mekatronik-achmadi/tugas_akhir/word_me/Cover.docx

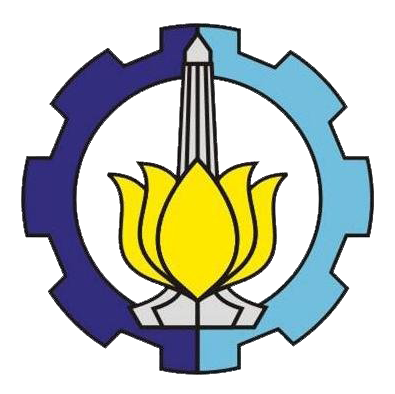
[picture p19: figure]

TUGAS AKHIR – TF 091381

Rancang Bangun Robot Vision Untuk Object

Finding Menggunakan Color Tracking pada

perangkat RaspberryPi

Achmadi

NRP. 2410 100 085

Dosen Pembimbing :

Ir Apriani Kusumawardhani

JURUSAN TEKNIK FISIKA

Fakultas Teknologi Industri

Institut Teknologi Sepuluh Nopember

Surabaya

2014
