mekatronik-achmadi/tugas_akhir/word_me/LAMPIRAN C.docx

LAMPIRAN C: KODE SUMBER C UNTUK FIRMWARE MOTOR CONTROLLER

Seluruh file ini dapat di akses di URL:

https://github.com/mekatronik-achmadi/tugas_akhir/tree/master/software/rtos

Seluruh kode sumber ini dibangun dengan operating system ubuntu atau debian. Kode sumber ini dibangun berdasarkan pustaka ChibiOS/RT yang merupakan pustaka untuk membangun firmware pada mikrokontroller berbasis ARM-Cortex M-series. Kode sumber yang terlampir disini hanyalah kode sumber yang dibuat dalam perancangan ini dan bukan termasuk kode bawaan dari pustaka ChibiOS/RT. File-file tersebut adalah:

1. halconf.h
2. mcuconf.h
3. robot_gpt.h
4. robot_led.h
5. robot_pal.h
6. robot_shell.h
7. srcconf.h
8. main.c
9. robot_gpt.c
10. robot_led.h
11. robot_pal.c
12. robot_shell.c
13. Makefile

Untuk dapat mengkompilasi kode sumber ini maka dibutuhkan paket berikut:

1. gcc-arm-none-eabi
2. libnewlib-arm-none-eabi
3. libnewlib-dev
4. build-essential

Untuk file kode sumber selain yang terlampir disini maka file tersebut merupakan bagian dari pustaka ChibiOS/RT yang digunakan tanpa ada perubahan.Untuk mengkompilasinya tinggal memanggil program make.

      1. File halconf.h

/**

* @file templates/halconf.h

* @brief HAL configuration header.

* @details HAL configuration file, this file allows to enable or disable the

* various device drivers from your application. You may also use

* this file in order to override the device drivers default settings.

*

* @addtogroup HAL_CONF

* @{

*/

#ifndef _HALCONF_H_

#define _HALCONF_H_

#include "mcuconf.h"

/**

* @brief Enables the TM subsystem.

*/

#if !defined(HAL_USE_TM) || defined(__DOXYGEN__)

#define HAL_USE_TM TRUE

#endif

/**

* @brief Enables the PAL subsystem.

*/

#if !defined(HAL_USE_PAL) || defined(__DOXYGEN__)

#define HAL_USE_PAL TRUE

#endif

/**

* @brief Enables the ADC subsystem.

*/

#if !defined(HAL_USE_ADC) || defined(__DOXYGEN__)

#define HAL_USE_ADC FALSE

#endif

/**

* @brief Enables the CAN subsystem.

*/

#if !defined(HAL_USE_CAN) || defined(__DOXYGEN__)

#define HAL_USE_CAN FALSE

#endif

/**

* @brief Enables the EXT subsystem.

*/

#if !defined(HAL_USE_EXT) || defined(__DOXYGEN__)

#define HAL_USE_EXT FALSE

#endif

/**

* @brief Enables the GPT subsystem.

*/

#if !defined(HAL_USE_GPT) || defined(__DOXYGEN__)

#define HAL_USE_GPT TRUE

#endif

/**

* @brief Enables the I2C subsystem.

*/

#if !defined(HAL_USE_I2C) || defined(__DOXYGEN__)

#define HAL_USE_I2C FALSE

#endif

/**

* @brief Enables the ICU subsystem.

*/

#if !defined(HAL_USE_ICU) || defined(__DOXYGEN__)

#define HAL_USE_ICU FALSE

#endif

/**

* @brief Enables the MAC subsystem.

*/

#if !defined(HAL_USE_MAC) || defined(__DOXYGEN__)

#define HAL_USE_MAC FALSE

#endif

/**

* @brief Enables the MMC_SPI subsystem.

*/

#if !defined(HAL_USE_MMC_SPI) || defined(__DOXYGEN__)

#define HAL_USE_MMC_SPI FALSE

#endif

/**

* @brief Enables the PWM subsystem.

*/

#if !defined(HAL_USE_PWM) || defined(__DOXYGEN__)

#define HAL_USE_PWM FALSE

#endif

/**

* @brief Enables the RTC subsystem.

*/

#if !defined(HAL_USE_RTC) || defined(__DOXYGEN__)

#define HAL_USE_RTC FALSE

#endif

/**

* @brief Enables the SDC subsystem.

*/

#if !defined(HAL_USE_SDC) || defined(__DOXYGEN__)

#define HAL_USE_SDC FALSE

#endif

/**

* @brief Enables the SERIAL subsystem.

*/

#if !defined(HAL_USE_SERIAL) || defined(__DOXYGEN__)

#define HAL_USE_SERIAL TRUE

#endif

/**

* @brief Enables the SERIAL over USB subsystem.

*/

#if !defined(HAL_USE_SERIAL_USB) || defined(__DOXYGEN__)

#define HAL_USE_SERIAL_USB FALSE

#endif

/**

* @brief Enables the SPI subsystem.

*/

#if !defined(HAL_USE_SPI) || defined(__DOXYGEN__)

#define HAL_USE_SPI FALSE

#endif

/**

* @brief Enables the UART subsystem.

*/

#if !defined(HAL_USE_UART) || defined(__DOXYGEN__)

#define HAL_USE_UART FALSE

#endif

/**

* @brief Enables the USB subsystem.

*/

#if !defined(HAL_USE_USB) || defined(__DOXYGEN__)

#define HAL_USE_USB FALSE

#endif

/*===========================================================================*/

/* ADC driver related settings. */

/*===========================================================================*/

/**

* @brief Enables synchronous APIs.

* @note Disabling this option saves both code and data space.

*/

#if !defined(ADC_USE_WAIT) || defined(__DOXYGEN__)

#define ADC_USE_WAIT TRUE

#endif

/**

* @brief Enables the @p adcAcquireBus() and @p adcReleaseBus() APIs.

* @note Disabling this option saves both code and data space.

*/

#if !defined(ADC_USE_MUTUAL_EXCLUSION) || defined(__DOXYGEN__)

#define ADC_USE_MUTUAL_EXCLUSION TRUE

#endif

/*===========================================================================*/

/* CAN driver related settings. */

/*===========================================================================*/

/**

* @brief Sleep mode related APIs inclusion switch.

*/

#if !defined(CAN_USE_SLEEP_MODE) || defined(__DOXYGEN__)

#define CAN_USE_SLEEP_MODE TRUE

#endif

/*===========================================================================*/

/* I2C driver related settings. */

/*===========================================================================*/

/**

* @brief Enables the mutual exclusion APIs on the I2C bus.

*/

#if !defined(I2C_USE_MUTUAL_EXCLUSION) || defined(__DOXYGEN__)

#define I2C_USE_MUTUAL_EXCLUSION TRUE

#endif

/*===========================================================================*/

/* MAC driver related settings. */

/*===========================================================================*/

/**

* @brief Enables an event sources for incoming packets.

*/

#if !defined(MAC_USE_ZERO_COPY) || defined(__DOXYGEN__)

#define MAC_USE_ZERO_COPY FALSE

#endif

/**

* @brief Enables an event sources for incoming packets.

*/

#if !defined(MAC_USE_EVENTS) || defined(__DOXYGEN__)

#define MAC_USE_EVENTS TRUE

#endif

/*===========================================================================*/

/* MMC_SPI driver related settings. */

/*===========================================================================*/

/**

* @brief Delays insertions.

* @details If enabled this options inserts delays into the MMC waiting

* routines releasing some extra CPU time for the threads with

* lower priority, this may slow down the driver a bit however.

* This option is recommended also if the SPI driver does not

* use a DMA channel and heavily loads the CPU.

*/

#if !defined(MMC_NICE_WAITING) || defined(__DOXYGEN__)

#define MMC_NICE_WAITING TRUE

#endif

/*===========================================================================*/

/* SDC driver related settings. */

/*===========================================================================*/

/**

* @brief Number of initialization attempts before rejecting the card.

* @note Attempts are performed at 10mS intervals.

*/

#if !defined(SDC_INIT_RETRY) || defined(__DOXYGEN__)

#define SDC_INIT_RETRY 100

#endif

/**

* @brief Include support for MMC cards.

* @note MMC support is not yet implemented so this option must be kept

* at @p FALSE.

*/

#if !defined(SDC_MMC_SUPPORT) || defined(__DOXYGEN__)

#define SDC_MMC_SUPPORT FALSE

#endif

/**

* @brief Delays insertions.

* @details If enabled this options inserts delays into the MMC waiting

* routines releasing some extra CPU time for the threads with

* lower priority, this may slow down the driver a bit however.

*/

#if !defined(SDC_NICE_WAITING) || defined(__DOXYGEN__)

#define SDC_NICE_WAITING TRUE

#endif

/*===========================================================================*/

/* SERIAL driver related settings. */

/*===========================================================================*/

/**

* @brief Default bit rate.

* @details Configuration parameter, this is the baud rate selected for the

* default configuration.

*/

#if !defined(SERIAL_DEFAULT_BITRATE) || defined(__DOXYGEN__)

#define SERIAL_DEFAULT_BITRATE 38400

#endif

/**

* @brief Serial buffers size.

* @details Configuration parameter, you can change the depth of the queue

* buffers depending on the requirements of your application.

* @note The default is 64 bytes for both the transmission and receive

* buffers.

*/

#if !defined(SERIAL_BUFFERS_SIZE) || defined(__DOXYGEN__)

#define SERIAL_BUFFERS_SIZE 32

#endif

/*===========================================================================*/

/* SPI driver related settings. */

/*===========================================================================*/

/**

* @brief Enables synchronous APIs.

* @note Disabling this option saves both code and data space.

*/

#if !defined(SPI_USE_WAIT) || defined(__DOXYGEN__)

#define SPI_USE_WAIT TRUE

#endif

/**

* @brief Enables the @p spiAcquireBus() and @p spiReleaseBus() APIs.

* @note Disabling this option saves both code and data space.

*/

#if !defined(SPI_USE_MUTUAL_EXCLUSION) || defined(__DOXYGEN__)

#define SPI_USE_MUTUAL_EXCLUSION TRUE

#endif

#endif /* _HALCONF_H_ */

/** @} */

      2. File mcuconf.h

#define STM32F103_MCUCONF

/*

* STM32F103 drivers configuration.

* The following settings override the default settings present in

* the various device driver implementation headers.

* Note that the settings for each driver only have effect if the whole

* driver is enabled in halconf.h.

*

* IRQ priorities:

* 15...0 Lowest...Highest.

*

* DMA priorities:

* 0...3 Lowest...Highest.

*/

/*

* HAL driver system settings.

*/

#define STM32_NO_INIT FALSE

#define STM32_HSI_ENABLED TRUE

#define STM32_LSI_ENABLED FALSE

#define STM32_HSE_ENABLED TRUE

#define STM32_LSE_ENABLED FALSE

#define STM32_SW STM32_SW_PLL

#define STM32_PLLSRC STM32_PLLSRC_HSE

#define STM32_PLLXTPRE STM32_PLLXTPRE_DIV1

#define STM32_PLLMUL_VALUE 9

#define STM32_HPRE STM32_HPRE_DIV1

#define STM32_PPRE1 STM32_PPRE1_DIV2

#define STM32_PPRE2 STM32_PPRE2_DIV2

#define STM32_ADCPRE STM32_ADCPRE_DIV4

#define STM32_USB_CLOCK_REQUIRED TRUE

#define STM32_USBPRE STM32_USBPRE_DIV1P5

#define STM32_MCOSEL STM32_MCOSEL_NOCLOCK

#define STM32_RTCSEL STM32_RTCSEL_HSEDIV

#define STM32_PVD_ENABLE FALSE

#define STM32_PLS STM32_PLS_LEV0

/*

* ADC driver system settings.

*/

#define STM32_ADC_USE_ADC1 FALSE

#define STM32_ADC_ADC1_DMA_PRIORITY 2

#define STM32_ADC_ADC1_IRQ_PRIORITY 6

/*

* CAN driver system settings.

*/

#define STM32_CAN_USE_CAN1 FALSE

#define STM32_CAN_CAN1_IRQ_PRIORITY 11

/*

* EXT driver system settings.

*/

#define STM32_EXT_EXTI0_IRQ_PRIORITY 6

#define STM32_EXT_EXTI1_IRQ_PRIORITY 6

#define STM32_EXT_EXTI2_IRQ_PRIORITY 6

#define STM32_EXT_EXTI3_IRQ_PRIORITY 6

#define STM32_EXT_EXTI4_IRQ_PRIORITY 6

#define STM32_EXT_EXTI5_9_IRQ_PRIORITY 6

#define STM32_EXT_EXTI10_15_IRQ_PRIORITY 6

#define STM32_EXT_EXTI16_IRQ_PRIORITY 6

#define STM32_EXT_EXTI17_IRQ_PRIORITY 6

#define STM32_EXT_EXTI18_IRQ_PRIORITY 6

#define STM32_EXT_EXTI19_IRQ_PRIORITY 6

/*

* GPT driver system settings.

*/

#define STM32_GPT_USE_TIM1 FALSE

#define STM32_GPT_USE_TIM2 FALSE

#define STM32_GPT_USE_TIM3 TRUE

#define STM32_GPT_USE_TIM4 FALSE

#define STM32_GPT_USE_TIM5 FALSE

#define STM32_GPT_USE_TIM8 FALSE

#define STM32_GPT_TIM1_IRQ_PRIORITY 7

#define STM32_GPT_TIM2_IRQ_PRIORITY 7

#define STM32_GPT_TIM3_IRQ_PRIORITY 7

#define STM32_GPT_TIM4_IRQ_PRIORITY 7

#define STM32_GPT_TIM5_IRQ_PRIORITY 7

#define STM32_GPT_TIM8_IRQ_PRIORITY 7

/*

* I2C driver system settings.

*/

#define STM32_I2C_USE_I2C1 FALSE

#define STM32_I2C_USE_I2C2 FALSE

#define STM32_I2C_I2C1_IRQ_PRIORITY 5

#define STM32_I2C_I2C2_IRQ_PRIORITY 5

#define STM32_I2C_I2C1_DMA_PRIORITY 3

#define STM32_I2C_I2C2_DMA_PRIORITY 3

#define STM32_I2C_I2C1_DMA_ERROR_HOOK() chSysHalt()

#define STM32_I2C_I2C2_DMA_ERROR_HOOK() chSysHalt()

/*

* ICU driver system settings.

*/

#define STM32_ICU_USE_TIM1 FALSE

#define STM32_ICU_USE_TIM2 FALSE

#define STM32_ICU_USE_TIM3 FALSE

#define STM32_ICU_USE_TIM4 FALSE

#define STM32_ICU_USE_TIM5 FALSE

#define STM32_ICU_USE_TIM8 FALSE

#define STM32_ICU_TIM1_IRQ_PRIORITY 7

#define STM32_ICU_TIM2_IRQ_PRIORITY 7

#define STM32_ICU_TIM3_IRQ_PRIORITY 7

#define STM32_ICU_TIM4_IRQ_PRIORITY 7

#define STM32_ICU_TIM5_IRQ_PRIORITY 7

#define STM32_ICU_TIM8_IRQ_PRIORITY 7

/*

* PWM driver system settings.

*/

#define STM32_PWM_USE_ADVANCED FALSE

#define STM32_PWM_USE_TIM1 FALSE

#define STM32_PWM_USE_TIM2 FALSE

#define STM32_PWM_USE_TIM3 FALSE

#define STM32_PWM_USE_TIM4 FALSE

#define STM32_PWM_USE_TIM5 FALSE

#define STM32_PWM_USE_TIM8 FALSE

#define STM32_PWM_TIM1_IRQ_PRIORITY 7

#define STM32_PWM_TIM2_IRQ_PRIORITY 7

#define STM32_PWM_TIM3_IRQ_PRIORITY 7

#define STM32_PWM_TIM4_IRQ_PRIORITY 7

#define STM32_PWM_TIM5_IRQ_PRIORITY 7

#define STM32_PWM_TIM8_IRQ_PRIORITY 7

/*

* RTC driver system settings.

*/

#define STM32_RTC_IRQ_PRIORITY 15

/*

* SERIAL driver system settings.

*/

#define STM32_SERIAL_USE_USART1 TRUE

#define STM32_SERIAL_USE_USART2 FALSE

#define STM32_SERIAL_USE_USART3 FALSE

#define STM32_SERIAL_USE_UART4 FALSE

#define STM32_SERIAL_USE_UART5 FALSE

#define STM32_SERIAL_USART1_PRIORITY 12

#define STM32_SERIAL_USART2_PRIORITY 12

#define STM32_SERIAL_USART3_PRIORITY 12

#define STM32_SERIAL_UART4_PRIORITY 12

#define STM32_SERIAL_UART5_PRIORITY 12

/*

* SPI driver system settings.

*/

#define STM32_SPI_USE_SPI1 FALSE

#define STM32_SPI_USE_SPI2 FALSE

#define STM32_SPI_USE_SPI3 FALSE

#define STM32_SPI_SPI1_DMA_PRIORITY 1

#define STM32_SPI_SPI2_DMA_PRIORITY 1

#define STM32_SPI_SPI3_DMA_PRIORITY 1

#define STM32_SPI_SPI1_IRQ_PRIORITY 10

#define STM32_SPI_SPI2_IRQ_PRIORITY 10

#define STM32_SPI_SPI3_IRQ_PRIORITY 10

#define STM32_SPI_DMA_ERROR_HOOK(spip) chSysHalt()

/*

* UART driver system settings.

*/

#define STM32_UART_USE_USART1 FALSE

#define STM32_UART_USE_USART2 FALSE

#define STM32_UART_USE_USART3 FALSE

#define STM32_UART_USART1_IRQ_PRIORITY 12

#define STM32_UART_USART2_IRQ_PRIORITY 12

#define STM32_UART_USART3_IRQ_PRIORITY 12

#define STM32_UART_USART1_DMA_PRIORITY 0

#define STM32_UART_USART2_DMA_PRIORITY 0

#define STM32_UART_USART3_DMA_PRIORITY 0

#define STM32_UART_DMA_ERROR_HOOK(uartp) chSysHalt()

/*

* USB driver system settings.

*/

#define STM32_USB_USE_USB1 FALSE

#define STM32_USB_LOW_POWER_ON_SUSPEND FALSE

#define STM32_USB_USB1_HP_IRQ_PRIORITY 13

#define STM32_USB_USB1_LP_IRQ_PRIORITY 14

      3. File robot_gpt.h

#ifndef ROBOT_GPT

#define ROBOT_GPT

#define F_GPT 100000

void Gpt_Setup(void);

#endif

      4. File robot_led.h

#ifndef ROBOT_LED

#define ROBOT_LED

#define L1 0

#define L2 1

#define L3 2

#define L4 3

#define L5 4

#define L6 5

#define L7 6

#define L8 7

#define L0 8

#define PORT_LED GPIOA

void Led_Setup(void);

#endif

5. File robot_pal.h

#ifndef ROBOT_PAL

#define ROBOT_PAL

#define O1 0

#define O2 1

#define O3 2

#define O4 3

#define O5 4

#define O6 5

#define O7 6

#define O8 7

#define O0 8

#define PORT_PAL GPIOC

#define LEFT_A O1

#define LEFT_B O2

#define LEFT_I L1

#define RIGHT_A O3

#define RIGHT_B O4

#define RIGHT_I L2

void Pal_Setup(void);

void Left_fow(void);

void Left_back(void);

void Right_fow(void);

void Right_back(void);

void Pal_clear(void);

#endif

6. File robot_shell.h

#ifndef ROBOT_SHELL

#define ROBOT_SHELL

#define SHELL_WA_SIZE THD_WA_SIZE(2048)

#define TEST_WA_SIZE THD_WA_SIZE(256)

#define STOP 0

#define FOWARD 1

#define BACKWARD 2

#define RIGHT 3

#define LEFT 4

void Serial_Setup(void);

void Shell_Setup(void);

#endif

7. File srcconf.h

#ifndef SRC_CONF

#define SRC_CONF

#include <stdio.h>

#include <string.h>

#include <stdint.h>

#include <stdarg.h>

#include <stdlib.h>

#include <math.h>

#include "ch.h"

#include "hal.h"

#include "memstreams.h"

#include "shell.h"

#include "chprintf.h"

#include "evtimer.h"

#include "robot_led.h"

#include "robot_shell.h"

#include "robot_pal.h"

#include "robot_gpt.h"

#define assert_param(expr) ((void)0)

#endif

8. File main.c

#include "srcconf.h"

/*

* Application entry point.

*/

int main(void) {

/*

* System initializations.

* - HAL initialization, this also initializes the configured device drivers

* and performs the board-specific initializations.

* - Kernel initialization, the main() function becomes a thread and the

* RTOS is active.

*/

halInit();

chSysInit();

/*

* Project defined HAL Setup

*/

Gpt_Setup();

Pal_Setup();

Led_Setup();

Serial_Setup();

while (TRUE) {

Shell_Setup(); /* create shell */

chThdSleepMilliseconds(500);

};

}

9. File robot_gpt.c

#include "srcconf.h"

uint16_t loop;

uint16_t value=10;

extern uint16_t dir;

static void gpt3cb(GPTDriver *gptp) {

(void)gptp;

loop++;

if(loop==value){

Pal_clear();

}

if(loop==100){

loop=0;

if(dir==FOWARD){

Right_fow();

Left_fow();

palClearPad(PORT_LED,RIGHT_I);

palClearPad(PORT_LED,LEFT_I);

}

else if(dir==BACKWARD){

Right_back();

Left_back();

palClearPad(PORT_LED,RIGHT_I);

palClearPad(PORT_LED,LEFT_I);

}

else if(dir==LEFT){

Right_back();

Left_fow();

palClearPad(PORT_LED,RIGHT_I);

palSetPad(PORT_LED,LEFT_I);

}

else if(dir==RIGHT){

Right_fow();

Left_back();

palSetPad(PORT_LED,RIGHT_I);

palClearPad(PORT_LED,LEFT_I);

}

else if(dir==STOP){

Pal_clear();

palSetPad(PORT_LED,RIGHT_I);

palSetPad(PORT_LED,LEFT_I);

}

}

chSysLockFromIsr();

gptStartOneShotI(&GPTD3, 10);

chSysUnlockFromIsr();

}

static const GPTConfig gpt3cfg = {

F_GPT, /* 10kHz timer clock.*/

gpt3cb, /* Timer callback.*/

0

};

void Gpt_Setup(void){

gptStart(&GPTD3, &gpt3cfg);

gptStartOneShot(&GPTD3, 10);

}

10. File robot_led.c

#include "srcconf.h"

static WORKING_AREA(wa_ledThread, 128);

static msg_t ledThread(void *arg) {

(void)arg;

while(TRUE){

chThdSleepMilliseconds(500);

palTogglePad(PORT_LED,L0);

}

return 0;

}

static WORKING_AREA(wa_ledTestThread, 128);

static msg_t ledTestThread(void *arg) {

(void)arg;

while(TRUE){

chThdSleepMilliseconds(1000);

palSetPad(PORT_LED,L1);

palSetPad(PORT_LED,L2);

palSetPad(PORT_LED,L3);

palSetPad(PORT_LED,L4);

palSetPad(PORT_LED,L5);

palSetPad(PORT_LED,L6);

palSetPad(PORT_LED,L7);

palSetPad(PORT_LED,L8);

chThdSleepMilliseconds(1000);

palClearPad(PORT_LED,L1);

palClearPad(PORT_LED,L2);

palClearPad(PORT_LED,L3);

palClearPad(PORT_LED,L4);

palClearPad(PORT_LED,L5);

palClearPad(PORT_LED,L6);

palClearPad(PORT_LED,L7);

palClearPad(PORT_LED,L8);

}

return 0;

}

void Led_Setup(void){

palSetPadMode(PORT_LED,L0,PAL_MODE_OUTPUT_PUSHPULL);

palSetPadMode(PORT_LED,L1,PAL_MODE_OUTPUT_PUSHPULL);

palSetPadMode(PORT_LED,L2,PAL_MODE_OUTPUT_PUSHPULL);

palSetPadMode(PORT_LED,L3,PAL_MODE_OUTPUT_PUSHPULL);

palSetPadMode(PORT_LED,L4,PAL_MODE_OUTPUT_PUSHPULL);

palSetPadMode(PORT_LED,L5,PAL_MODE_OUTPUT_PUSHPULL);

palSetPadMode(PORT_LED,L6,PAL_MODE_OUTPUT_PUSHPULL);

palSetPadMode(PORT_LED,L7,PAL_MODE_OUTPUT_PUSHPULL);

palSetPadMode(PORT_LED,L8,PAL_MODE_OUTPUT_PUSHPULL);

palSetPad(PORT_LED,L0);

palSetPad(PORT_LED,L1);

palSetPad(PORT_LED,L2);

palSetPad(PORT_LED,L3);

palSetPad(PORT_LED,L4);

palSetPad(PORT_LED,L5);

palSetPad(PORT_LED,L6);

palSetPad(PORT_LED,L7);

palSetPad(PORT_LED,L8);

chThdCreateStatic(wa_ledThread, sizeof(wa_ledThread), NORMALPRIO, ledThread, NULL);

//chThdCreateStatic(wa_ledTestThread, sizeof(wa_ledTestThread), NORMALPRIO, ledTestThread, NULL);

}

11. File robot_pal.c

#include "srcconf.h"

void Right_fow(void){

palSetPad(PORT_PAL,RIGHT_B);

palClearPad(PORT_PAL,RIGHT_A);

palClearPad(PORT_LED,RIGHT_I);

}

void Right_back(void){

palSetPad(PORT_PAL,RIGHT_A);

palClearPad(PORT_PAL,RIGHT_B);

palSetPad(PORT_LED,RIGHT_I);

}

void Left_fow(void){

palSetPad(PORT_PAL,LEFT_B);

palClearPad(PORT_PAL,LEFT_A);

palClearPad(PORT_LED,LEFT_I);

}

void Left_back(void){

palSetPad(PORT_PAL,LEFT_A);

palClearPad(PORT_PAL,LEFT_B);

palSetPad(PORT_LED,LEFT_I);

}

void Pal_clear(void){

palClearPad(PORT_PAL,LEFT_A);

palClearPad(PORT_PAL,LEFT_B);

palClearPad(PORT_PAL,RIGHT_A);

palClearPad(PORT_PAL,RIGHT_B);

}

static WORKING_AREA(wa_palTestThread, 128);

static msg_t palTestThread(void *arg) {

(void)arg;

while(TRUE){

Left_back();

Right_fow();

chThdSleepMilliseconds(1000);

Left_fow();

Right_back();

chThdSleepMilliseconds(1000);

}

return 0;

}

void Pal_Setup(void){

palSetPadMode(PORT_PAL,O1,PAL_MODE_OUTPUT_PUSHPULL);

palSetPadMode(PORT_PAL,O2,PAL_MODE_OUTPUT_PUSHPULL);

palSetPadMode(PORT_PAL,O3,PAL_MODE_OUTPUT_PUSHPULL);

palSetPadMode(PORT_PAL,O4,PAL_MODE_OUTPUT_PUSHPULL);

palSetPadMode(PORT_PAL,O5,PAL_MODE_OUTPUT_PUSHPULL);

palSetPadMode(PORT_PAL,O6,PAL_MODE_OUTPUT_PUSHPULL);

palSetPadMode(PORT_PAL,O7,PAL_MODE_OUTPUT_PUSHPULL);

palSetPadMode(PORT_PAL,O8,PAL_MODE_OUTPUT_PUSHPULL);

//chThdCreateStatic(wa_palTestThread, sizeof(wa_palTestThread), NORMALPRIO, palTestThread, NULL);

}

12. File robot_shell.c

#include "srcconf.h"

uint16_t dir;

Thread *shelltp = NULL;

static void cmd_test(BaseSequentialStream *chp, int argc, char *argv[]) {

(void)argv;

if(argc>0){

chprintf(chp,"bad commands\n\r");

return;

}

chprintf(chp,"serial ok !!\n\r");

return;

}

static void cmd_foward(BaseSequentialStream *chp, int argc, char *argv[]) {

(void)argv;

if(argc>0){

chprintf(chp,"bad commands\n\r");

return;

}

dir=FOWARD;

chThdSleepMilliseconds(250);

dir=STOP;

return;

}

static void cmd_backward(BaseSequentialStream *chp, int argc, char *argv[]) {

(void)argv;

if(argc>0){

chprintf(chp,"bad commands\n\r");

return;

}

dir=BACKWARD;

chThdSleepMilliseconds(250);

dir=STOP;

return;

}

static void cmd_right(BaseSequentialStream *chp, int argc, char *argv[]) {

(void)argv;

if(argc>0){

chprintf(chp,"bad commands\n\r");

return;

}

dir=RIGHT;

chThdSleepMilliseconds(50);

dir=STOP;

return;

}

static void cmd_left(BaseSequentialStream *chp, int argc, char *argv[]) {

(void)argv;

if(argc>0){

chprintf(chp,"bad commands\n\r");

return;

}

dir=LEFT;

chThdSleepMilliseconds(50);

dir=STOP;

return;

}

static void cmd_stop(BaseSequentialStream *chp, int argc, char *argv[]) {

(void)argv;

if(argc>0){

chprintf(chp,"bad commands\n\r");

return;

}

dir=STOP;

return;

}

static void cmd_booted(BaseSequentialStream *chp, int argc, char *argv[]) {

(void)argv;

if(argc>0){

chprintf(chp,"bad commands\n\r");

return;

}

palTogglePad(PORT_LED,L3);

return;

}

static const ShellCommand commands[] = {

{"test",cmd_test},

{"foward",cmd_foward},

{"backward",cmd_backward},

{"right",cmd_right},

{"left",cmd_left},

{"stop",cmd_stop},

{"booted",cmd_booted},

{NULL, NULL}

};

static const ShellConfig shell_cfg1 = {

(BaseSequentialStream *)&SD1,

commands

};

void Serial_Setup(void){

palSetPadMode(GPIOA,9,16);

palSetPadMode(GPIOA,10,2);

sdStart(&SD1,NULL);

shellInit();

}

void Shell_Setup(void){

if (!shelltp){

shelltp = shellCreate(&shell_cfg1, SHELL_WA_SIZE, NORMALPRIO);} /* create shell tread */

else if (chThdTerminated(shelltp)) {

chThdRelease(shelltp); /* Recovers memory of the previous shell. */

shelltp = NULL; /* Triggers spawning of a new shell. */

}

}

13. File Makefile

ifeq ($(USE_OPT),)

USE_OPT = -O2 -ggdb -fomit-frame-pointer -falign-functions=16

endif

# C specific options here (added to USE_OPT).

ifeq ($(USE_COPT),)

USE_COPT =

endif

# C++ specific options here (added to USE_OPT).

ifeq ($(USE_CPPOPT),)

USE_CPPOPT = -fno-rtti

endif

# Enable this if you want the linker to remove unused code and data

ifeq ($(USE_LINK_GC),)

USE_LINK_GC = yes

endif

# If enabled, this option allows to compile the application in THUMB mode.

ifeq ($(USE_THUMB),)

USE_THUMB = yes

endif

# Enable this if you want to see the full log while compiling.

ifeq ($(USE_VERBOSE_COMPILE),)

USE_VERBOSE_COMPILE = no

endif

# Build global options

# Architecture or project specific options

# Enable this if you really want to use the STM FWLib.

ifeq ($(USE_FWLIB),)

USE_FWLIB = no

endif

# Architecture or project specific options

# Project, sources and paths

# Define project name here

PROJECT = robot

# Imported source files and paths

CHIBIOS = ..

include $(CHIBIOS)/boards/STM32/board.mk

include $(CHIBIOS)/os/hal/platforms/STM32F1xx/platform.mk

include $(CHIBIOS)/os/hal/hal.mk

include $(CHIBIOS)/os/ports/GCC/ARMCMx/STM32F1xx/port.mk

include $(CHIBIOS)/os/kernel/kernel.mk

# Define linker script file here

LDSCRIPT= $(PORTLD)/STM32F103xB.ld

# C sources that can be compiled in ARM or THUMB mode depending on the global

# setting.

CSRC = $(PORTSRC) \

$(KERNSRC) \

$(TESTSRC) \

$(HALSRC) \

$(PLATFORMSRC) \

$(BOARDSRC) \

$(CHIBIOS)/os/various/syscalls.c \

$(CHIBIOS)/os/various/evtimer.c \

$(CHIBIOS)/os/various/shell.c \

$(CHIBIOS)/os/various/chprintf.c \

$(CHIBIOS)/os/various/memstreams.c \

main.c robot_led.c robot_pal.c robot_gpt.c robot_shell.c

# C++ sources that can be compiled in ARM or THUMB mode depending on the global

# setting.

CPPSRC =

# C sources to be compiled in ARM mode regardless of the global setting.

# NOTE: Mixing ARM and THUMB mode enables the -mthumb-interwork compiler

# option that results in lower performance and larger code size.

ACSRC =

# C++ sources to be compiled in ARM mode regardless of the global setting.

# NOTE: Mixing ARM and THUMB mode enables the -mthumb-interwork compiler

# option that results in lower performance and larger code size.

ACPPSRC =

# C sources to be compiled in THUMB mode regardless of the global setting.

# NOTE: Mixing ARM and THUMB mode enables the -mthumb-interwork compiler

# option that results in lower performance and larger code size.

TCSRC =

# C sources to be compiled in THUMB mode regardless of the global setting.

# NOTE: Mixing ARM and THUMB mode enables the -mthumb-interwork compiler

# option that results in lower performance and larger code size.

TCPPSRC =

# List ASM source files here

ASMSRC = $(PORTASM)

INCDIR = $(PORTINC) $(KERNINC) $(TESTINC) \

$(HALINC) $(PLATFORMINC) $(BOARDINC) \

$(CHIBIOS)/os/various

# Project, sources and paths

# Compiler settings

MCU = cortex-m3

#TRGT = arm-elf-

TRGT = arm-none-eabi-

CC = $(TRGT)gcc

CPPC = $(TRGT)g++

# Enable loading with g++ only if you need C++ runtime support.

# NOTE: You can use C++ even without C++ support if you are careful. C++

# runtime support makes code size explode.

LD = $(TRGT)gcc

#LD = $(TRGT)g++

CP = $(TRGT)objcopy

AS = $(TRGT)gcc -x assembler-with-cpp

OD = $(TRGT)objdump

HEX = $(CP) -O ihex

BIN = $(CP) -O binary

# ARM-specific options here

AOPT =

# THUMB-specific options here

TOPT = -mthumb -DTHUMB

# Define C warning options here

CWARN = -Wall -Wextra -Wstrict-prototypes

# Define C++ warning options here

CPPWARN = -Wall -Wextra

# Compiler settings

# Start of default section

# List all default C defines here, like -D_DEBUG=1

DDEFS =

# List all default ASM defines here, like -D_DEBUG=1

DADEFS =

# List all default directories to look for include files here

DINCDIR =

# List the default directory to look for the libraries here

DLIBDIR =

# List all default libraries here

DLIBS =

# End of default section

# Start of user section

# List all user C define here, like -D_DEBUG=1

UDEFS =

# Define ASM defines here

UADEFS =

# List all user directories here

UINCDIR =

# List the user directory to look for the libraries here

ULIBDIR =

# List all user libraries here

ULIBS =

# End of user defines

ifeq ($(USE_FWLIB),yes)

include $(CHIBIOS)/ext/stm32lib/stm32lib.mk

CSRC += $(STM32SRC)

INCDIR += $(STM32INC)

USE_OPT += -DUSE_STDPERIPH_DRIVER

endif

include $(CHIBIOS)/os/ports/GCC/ARMCMx/rules.mk
