mekatronik-achmadi/tugas_akhir/word_me/Biblio.docx

DAFTAR PUSTAKA

- Ale Ude.2010. ” Robot Vision ”.In-Tech:Croatia

- Andor Team.2012.” Digital Camera Fundamentals”. Andor Publisher: USA

- Browning, Brett.2013. ” Real-Time, Adaptive Color-based Robot Vision ”.Carnigie Mellon University:USA

- Chao, Fei.2014. ” A developmental approach to robotic pointing via humanrobot interaction ”.Xiamen University:China

- Honda Team.2007. ” Asimo Technical Information ” Honda Press:Japan

- Aldebaran Robotics.2012 ” Nao Technical Datasheet ” Aldebaran Press:France

- Robotis.2012 ” Darwin-Op Technical Manual ” Robotis Inc:Korea

- Upton, Eben.2012 ” RaspberryPi User Guide”.RaspberrPi.org:UK

- OpenCV Team.2014” The OpenCV Reference Manual ” OpenCV.org:USA

- Phillips, Dwyne.2000 ” Image Processing in C ” R&D Publisher: USA.

- Zhou, Huiyu.2010 ” Digital Image Processing Part I ” BookBon:2010
