mekatronik-achmadi/tugas_akhir/presentasi/sem_pro/sem_pro.pdf

## Rancang Bangun Robot Vision Untuk Object Finding Menggunakan Color Tracking pada perangkat RaspberryPi

Institut Teknologi Sepuluh November

Oleh:
Achmadi 2410100085

Pembimbing:
Ir. Apriani K. MSc NIP: 195304041979012001
(Achmadi ITS) | Robot Vision | 1 / 24

Overview 1 Pendahuluan

Latar Belakang
Rumusan Masalah
Batasan Masalah
2 | | | | | Teori Penunjang Mode Warna HSV Thresholding Titik Pusat OpenCV Raspbian
3 | Metode Penelitian 4 | Jadwal Pengerjaan 5 | Daftar Pustaka 6 | Pencapaian terkini 7 | Catatan

## Latar Belakang

Robot Membantu Manusia

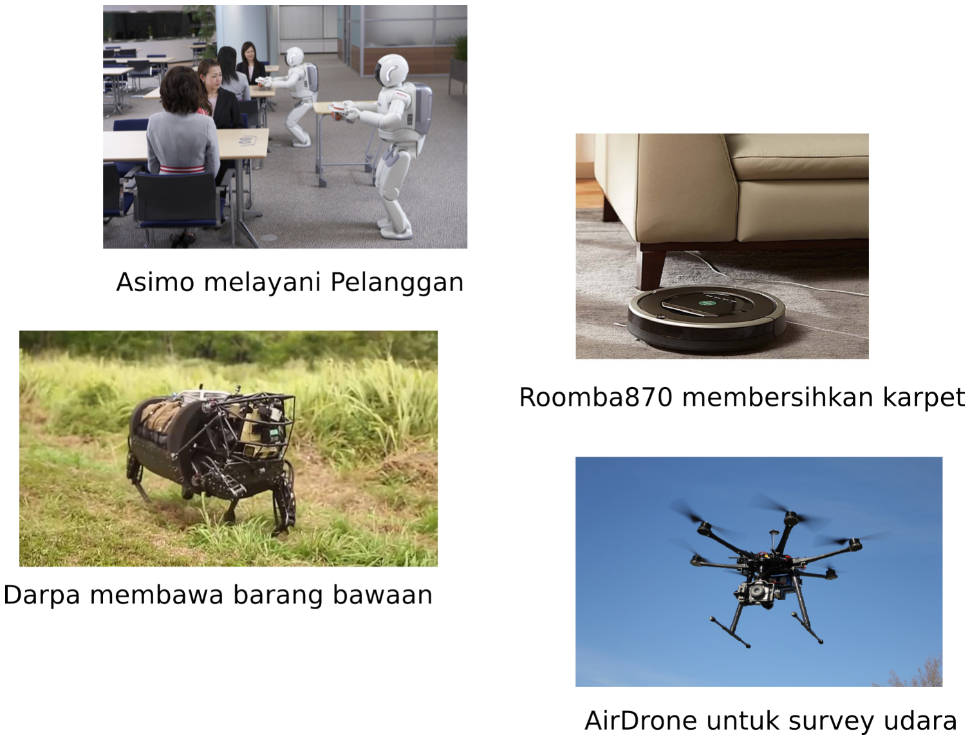
[picture p34: figure]

## Latar Belakang

Sensor Robot

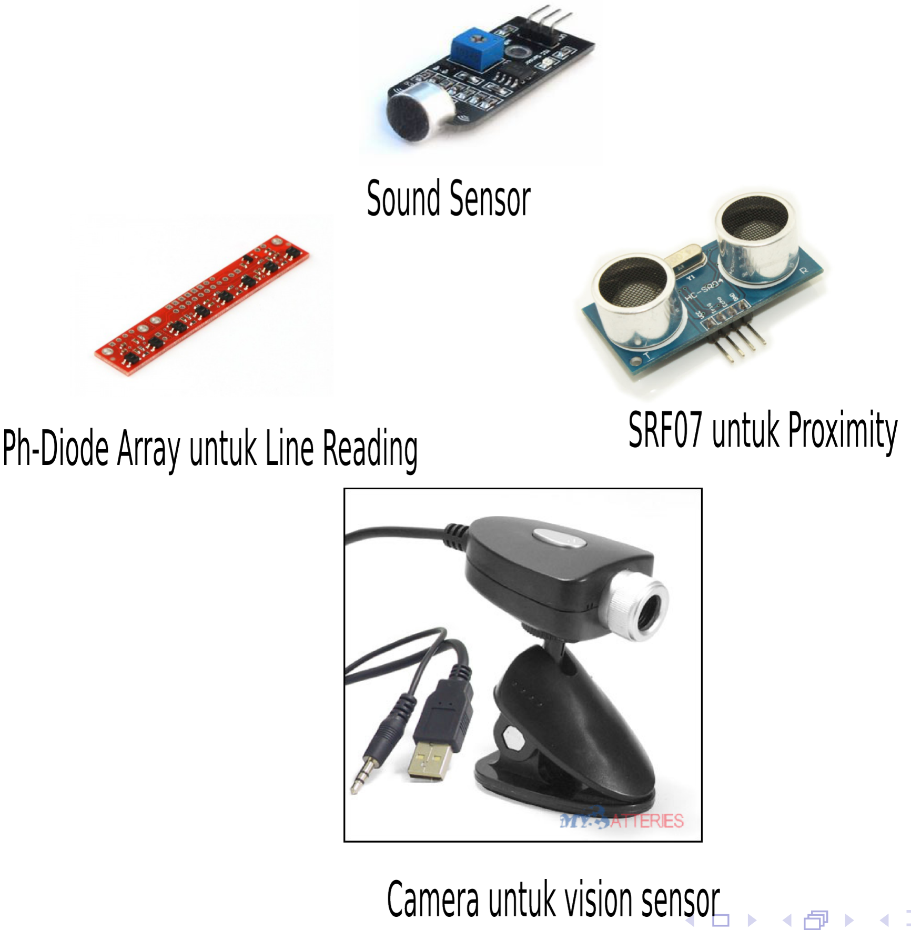
[picture p35: figure]

## Latar Belakang

Mengapa Vision Digunakan?

[Brett, 2010]

Dengan ketersediaannya yang luas, konten informasi tinggi, dan kesesuaian untuk lingkungan manusia serta harga yang murah dari kamera warna, sistem vision menjadi cocok untuk banyak platform robot.

## Latar Belakang

Contoh Vision: Asimo

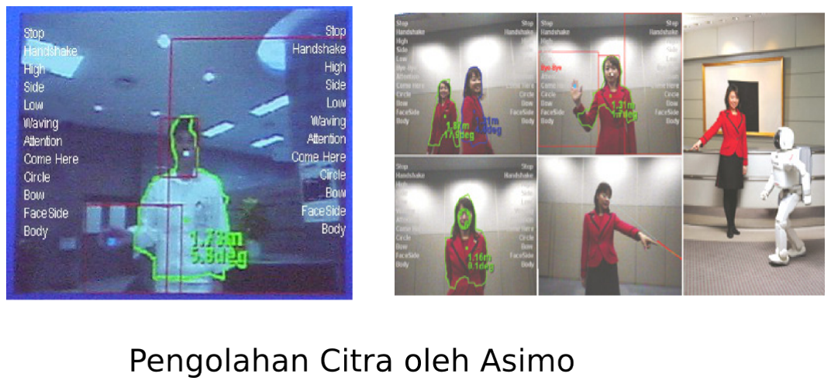
[picture p36: figure]

[Honda, 2007]

Jenis Kamera : CCD
Processor : 20 Unit Honda Propietary CPU Harga : $2.500.000

## Latar Belakang

Alternatif CPU Murah

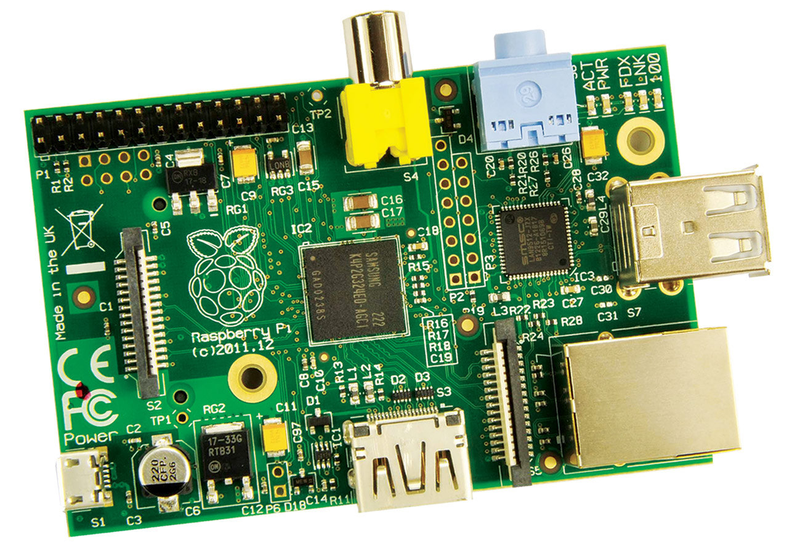
[picture p37: figure]
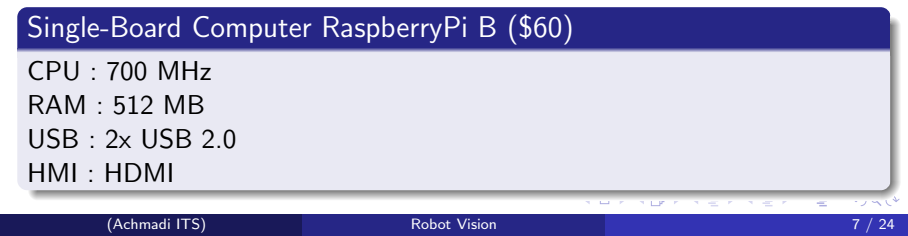
[picture p38: figure]
Single-Board Computer RaspberryPi B ($60); CPU : 700 MHz RAM : 512 MB USB : 2x USB 2.0 HMI : HDMI

## Rumusan Masalah

Bagaimana merancang bangun robot vision berbasis color tracking menggunakan OpenCV pada perangkat RaspberryPi.

## Batasan Masalah

Kajian rancang bangun robot yang menggunakan kamera dan pengolahan citra untuk menemukan objek berdasarkan warna yang dimiliki objek tersebut.

Objek yang akan diolah telah ditentukan ukuran dan warnanya.

Robot bekerja pada tingkat pencahayaan yang telah diatur.

Overview 1 Pendahuluan

Latar Belakang
Rumusan Masalah
Batasan Masalah
2 | | | | | Teori Penunjang Mode Warna HSV Thresholding Titik Pusat OpenCV Raspbian
3 | Metode Penelitian 4 | Jadwal Pengerjaan 5 | Daftar Pustaka 6 | Pencapaian terkini 7 | Catatan

## Mode Warna HSV

Mode Warna yang mengkarakteristikan warna dalam 3 variabel, yaitu Hue, Saturation, dan Value

Hue adalah nilai warna dalam satuan sudut. Hue di plot dalam diagram berbentuk lingkaran dengan warna Red, Green, dan Blue terpisah dalam sudut 120 derajat. Warna lainnya merupakan tingkat campuran dari ketiga warna tersebut.

Saturation adalah nilai tingkat suatu warna terhadap warna Hitam. Tingkat Pencahayaan dapat mempengaruhi nilai Saturation.

Value adalah nilai tingkat suatu warna terhadap warna Putih. Tingkat Pencahayaan dapat mempengaruhi nilai Saturation.

## Mode Warna HSV

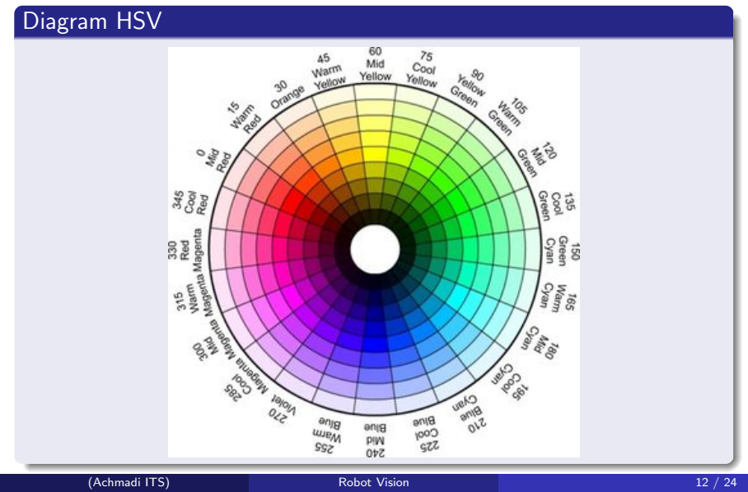
[picture p39: figure]
Diagram HSV

## Mode Warna HSV

Konversi RGB ke HSV
Kamera menghasilkan gambar dalam mode RGB maka perlu dikonversi ke HSV sebelum proses lebih lanjut.
V = max(R, G, B) | (1)

S =

(V −min(R,G,B)
V

, jika V 6= 0

0, | jika V = 0

(2)

H =

60(G−B)
(V −min(R,G,B)) , | jika V = R
120 + | 60(B−R)
(V −min(R,G,B)) , jika V = G
240 + 60(R−G)
(V −min(R,G,B)) , jika V = B

(3)

## Thresholding

Thresholding adalah proses menyeleksi pixel berdasarkan range nilai HSV yang telah ditentukan.

Untuk pixel (8bit) yang sesuai jangkauan maka nilainya dikonversi ke 255 (putih). Jika tidak sebaliknya maka nilainya dikonversi ke 0 (hitam).

P(i, j) = (
255, Hmin ≤ H ≤ Hmax ∧ Smin ≤ S ≤ Smax ∧ Vmin ≤ V ≤ Vmax

0, selainnya
(4)

## Titik Pusat

Titik Pusat (Centroid) adalah titik yang menjadi pusat luasan dari total luas pixel. Titik ini identik dengan pusat massa untuk benda 2D.

x =

x1 ∗ m1 + x2 ∗ m2 + x3 ∗ m3 + ... m1 + m2 + m3 + ...

(5)

y =

y1 ∗ n1 + y2 ∗ n2 + y3 ∗ n3 + ... n1 + n2 + n3 + ...

(6)

## OpenCV

OpenCV (Open Computer Vision) adalah pustaka pemrograman untuk pengolahan citra yang bersifat opensource.

OpenCV mendukung bahasa pemrograman C, C++, dan Python.

OpenCV menyediakan fungsi-fungsi pengolahan citra yang lengkap mulai dari perhitungan histogram hingga algoritma Haar-Cascade untuk deteksi wajah.

OpenCV dapat digunakan sebagai pengganti Matlab untuk proses pengolahan citra yang mengharuskan program ditulis dalam C atau C++.

## Raspbian

Raspbian adalah Operating System berbasis Debian yang dijalankan di platform RaspberryPi.

Raspbian menggunakan kernel Linux untuk arsitektur armhf.

Melalui Raspbian ini nantinya menjalankan OpenCV untuk pengolahan citra dan komunikasi serial untuk mengontrol robot.

Lumbung Software (Repository) dari Raspbian telah menyediakan binary siap pakai sehingga memudahkan instalasi.

Overview 1 Pendahuluan

Latar Belakang
Rumusan Masalah
Batasan Masalah
2 | | | | | Teori Penunjang Mode Warna HSV Thresholding Titik Pusat OpenCV Raspbian
3 | Metode Penelitian 4 | Jadwal Pengerjaan 5 | Daftar Pustaka 6 | Pencapaian terkini 7 | Catatan

## Flow Chart Pengerjaan

## Jadwal Pengerjaan

No | Kegiatan | Bulan
| | Oktober | November | Desember
1 | Studi literatur
2 | Perancangan dan Pembuatan
3 | Pengambilan Data
4 | Analisa Data
5 | Penulisan Laporan

## Daftar Pustaka

Brett Browning, Manuela Veloso Real-Time, Adaptive Color-based Robot Vision 2010

Honda Public Division Asimo Technical Information 2007

Ale Ude Robot Vision 2010

Andor Team Digital Camera Fundamentals 2012

Chao, Fei A developmental approach to robotic pointing via humanrobot interaction 2014

Upton, Eben RaspberryPi User Guide 2012

OpenCV Team The OpenCV Reference Manual 2014

Phillips, Dwyne Image Processing in C 2000

Zhou, Huiyu Digital Image Processing Part I 2010

# Mator Sakalangkong

## Pencapaian terkini

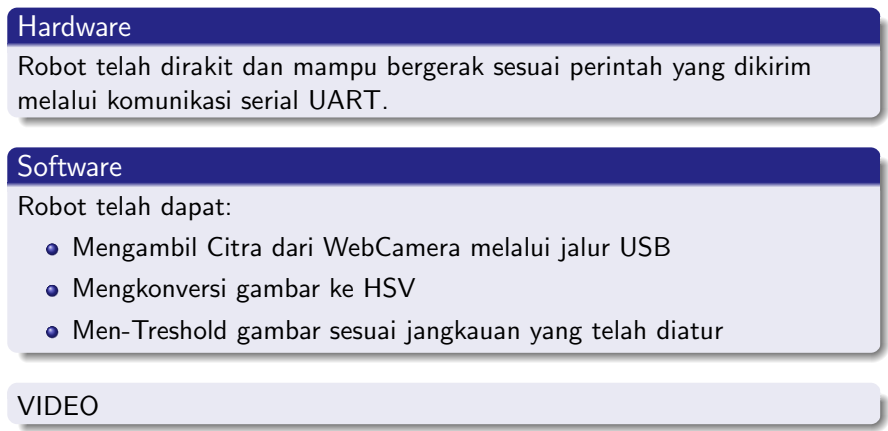
[picture p40: figure]
Hardware; melalui komunikasi serial UART.; Software; Robot telah dapat:; Mengkonversi gambar ke HSV; VIDEO

Robot telah dirakit dan mampu bergerak sesuai perintah yang dikirim

Mengambil Citra dari WebCamera melalui jalur USB

Men-Treshold gambar sesuai jangkauan yang telah diatur

## Catatan
