mekatronik-achmadi/tugas_akhir/driver/driver_controller_brd.png

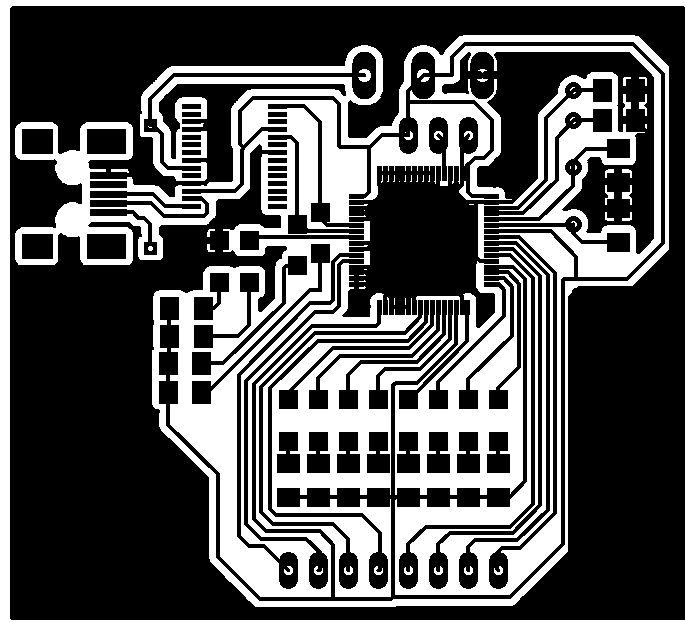
driver/driver_controller_brd.png
