mekatronik-achmadi/tugas_akhir/driver/driver_fet_brd.png

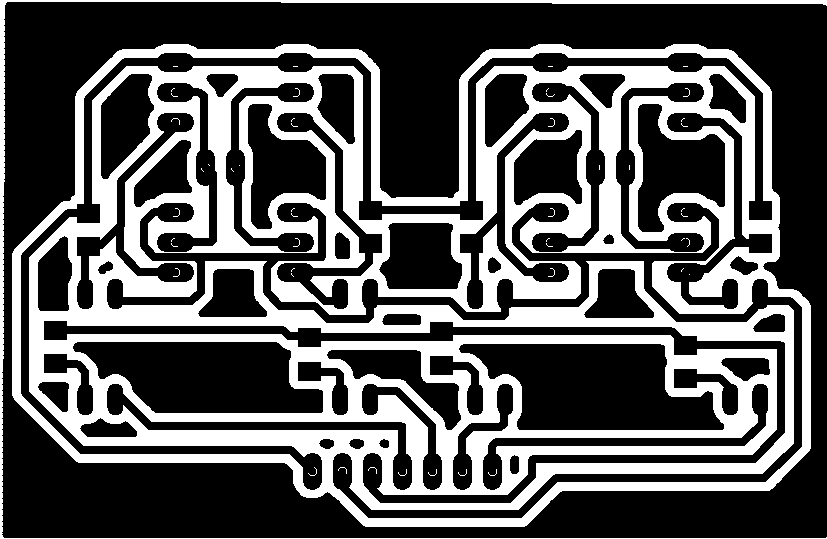
driver/driver_fet_brd.png
