mekatronik-achmadi/tugas_akhir/poster/buat_poster.png

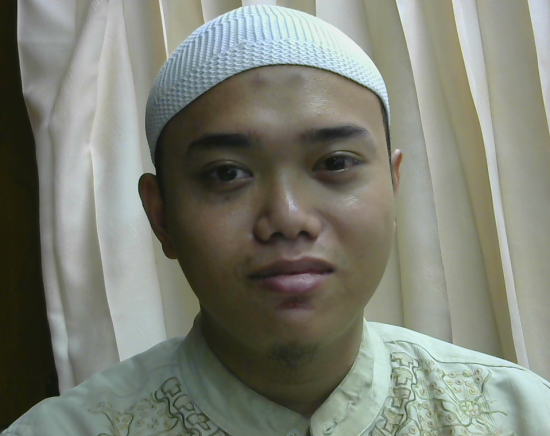
poster/buat_poster.png
