mekatronik-achmadi/tugas_akhir/poster/poster.jpg

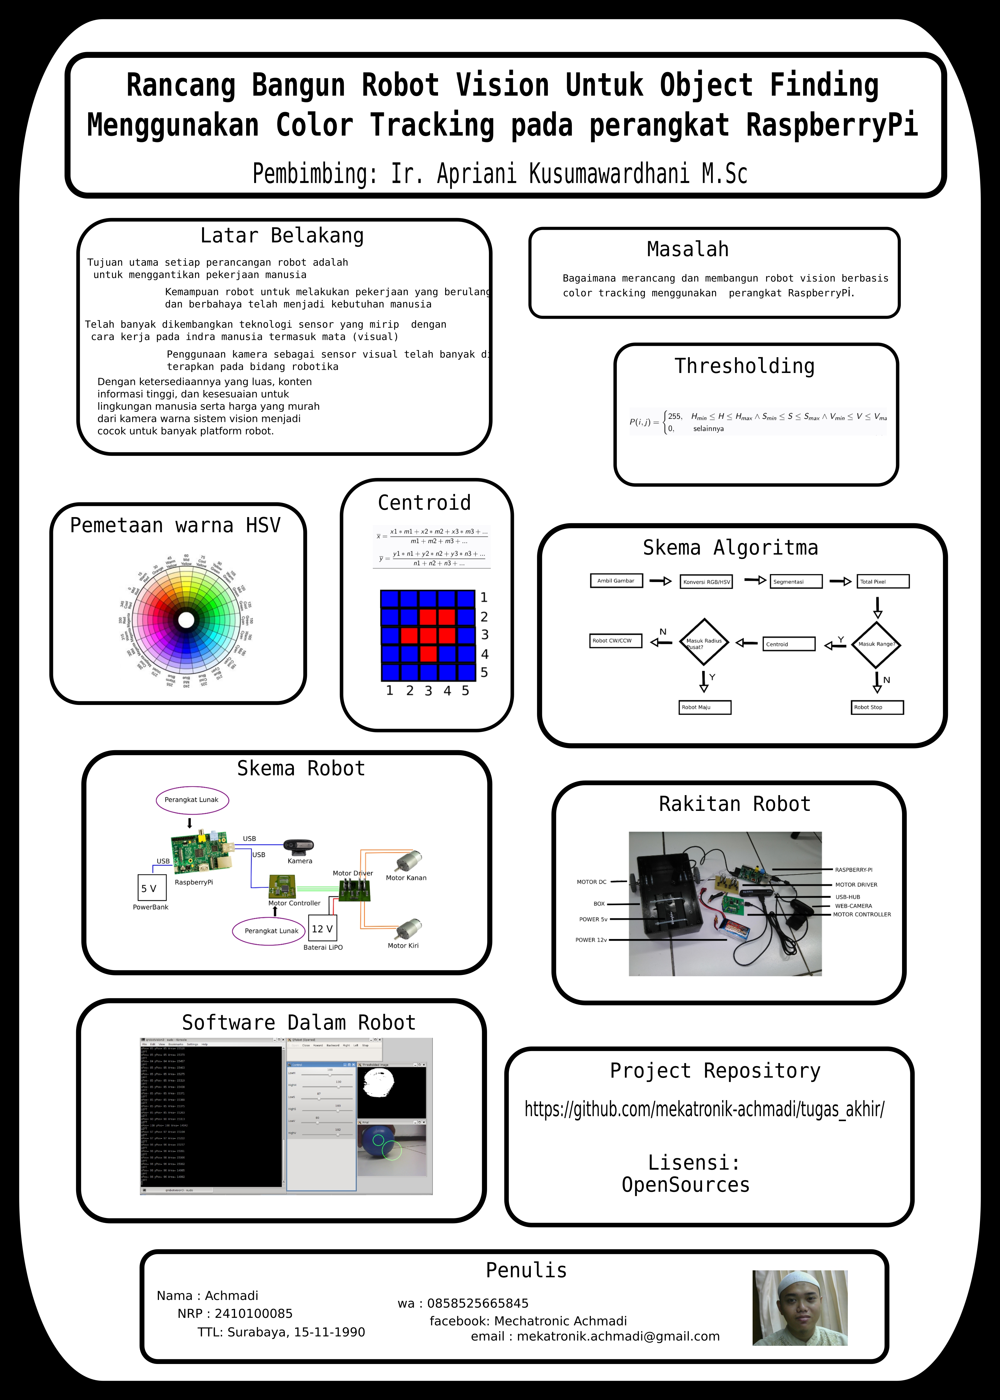
poster/poster.jpg
