mekatronik-achmadi/tugas_akhir/driver/driver_fet.brd

## EAGLE design driver/driver_fet.brd (2015-01-02)

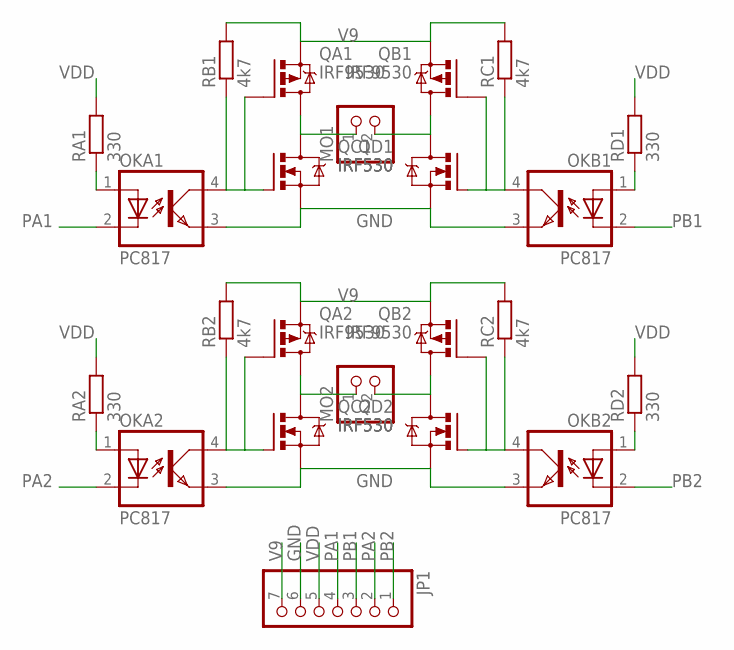
[picture p56: schematic driver_fet.sch]

Parts:
JP1: PINHD-1X7; 1X07
MO1, MO2: PINHD-1X2; 1X02
OKA1, OKA2: PC817; DIL04
OKB1, OKB2: PC817; DIL04
QA1, QA2: IRF9530; TO220BV
QB1, QB2: IRF9530; TO220BV
QC1, QC2: IRF530; TO220BV
QD1, QD2: IRF530; TO220BV
RA1, RA2: 330; R1206
RB1, RB2: 4k7; R1206
RC1, RC2: 4k7; R1206
RD1, RD2: 330; R1206

Connections:
GND: JP1.6, OKA1.3 (EMIT), OKA2.3 (EMIT), OKB1.3 (EMIT), OKB2.3 (EMIT), QC1.S, QC2.S, QD1.S, QD2.S
unnamed: MO1.1, QA1.D, QC1.D
unnamed: MO1.2, QB1.D, QD1.D
unnamed: MO2.1, QA2.D, QC2.D
unnamed: MO2.2, QB2.D, QD2.D
unnamed: OKA1.4 (COL), QA1.G, QC1.G, RB1.1
unnamed: OKB1.4 (COL), QB1.G, QD1.G, RC1.1
unnamed: OKA2.4 (COL), QA2.G, QC2.G, RB2.1
unnamed: OKA1.1 (A), RA1.1
unnamed: OKB1.1 (A), RD1.1
unnamed: OKB2.4 (COL), QB2.G, QD2.G, RC2.1
unnamed: OKA2.1 (A), RA2.1
unnamed: OKB2.1 (A), RD2.1
PA1: JP1.4, OKA1.2 (C)
PA2: JP1.2, OKA2.2 (C)
PB1: JP1.3, OKB1.2 (C)
PB2: JP1.1, OKB2.2 (C)
V9: JP1.7, QA1.S, QA2.S, QB1.S, QB2.S, RB1.2, RB2.2, RC1.2, RC2.2
VDD: JP1.5, RA1.2, RA2.2, RD1.2, RD2.2

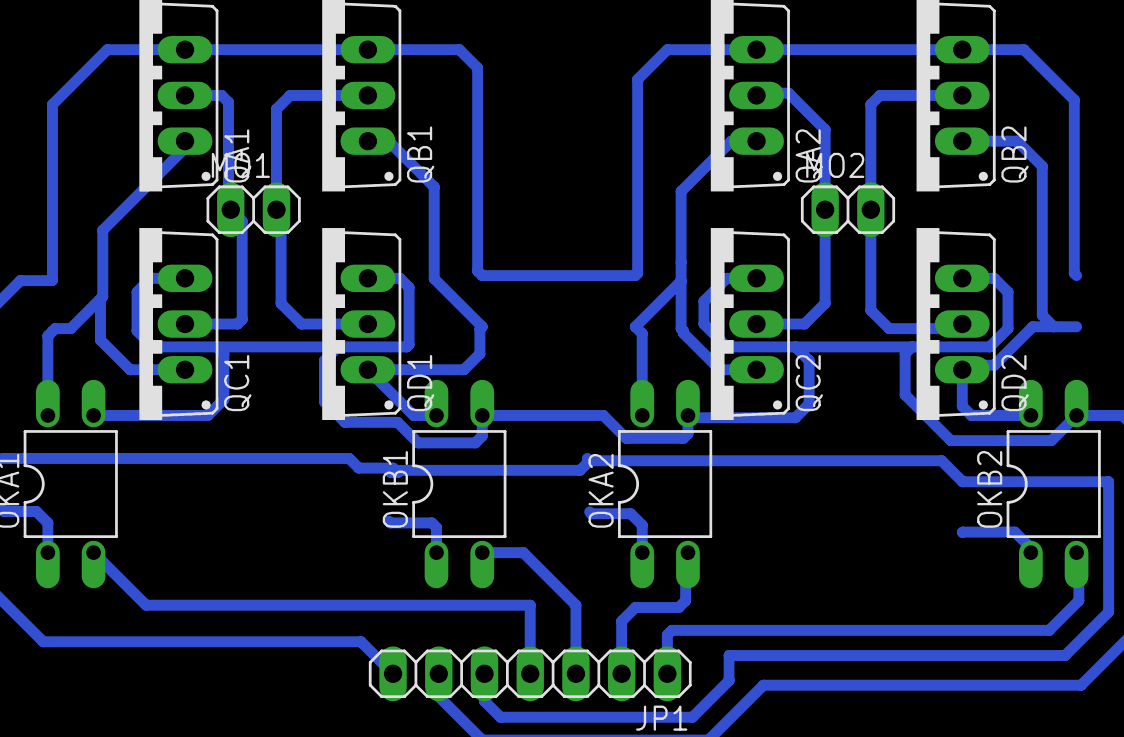
[picture p57: board driver_fet.brd from above]

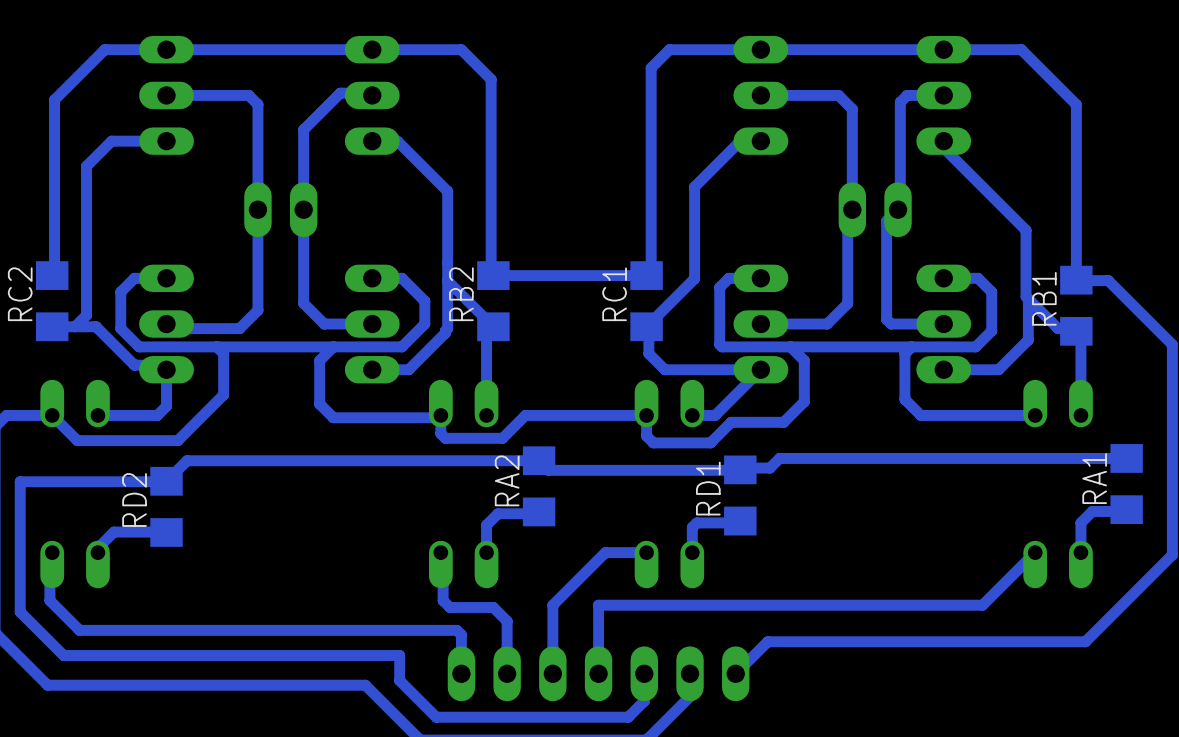
[picture p58: board driver_fet.brd from below]

Board: 2 copper layers, 23 parts (8 on the bottom side), 19 nets.
