mekatronik-achmadi/tugas_akhir/driver/driver_controller.brd

## EAGLE design driver/driver_controller.brd (2015-01-02)

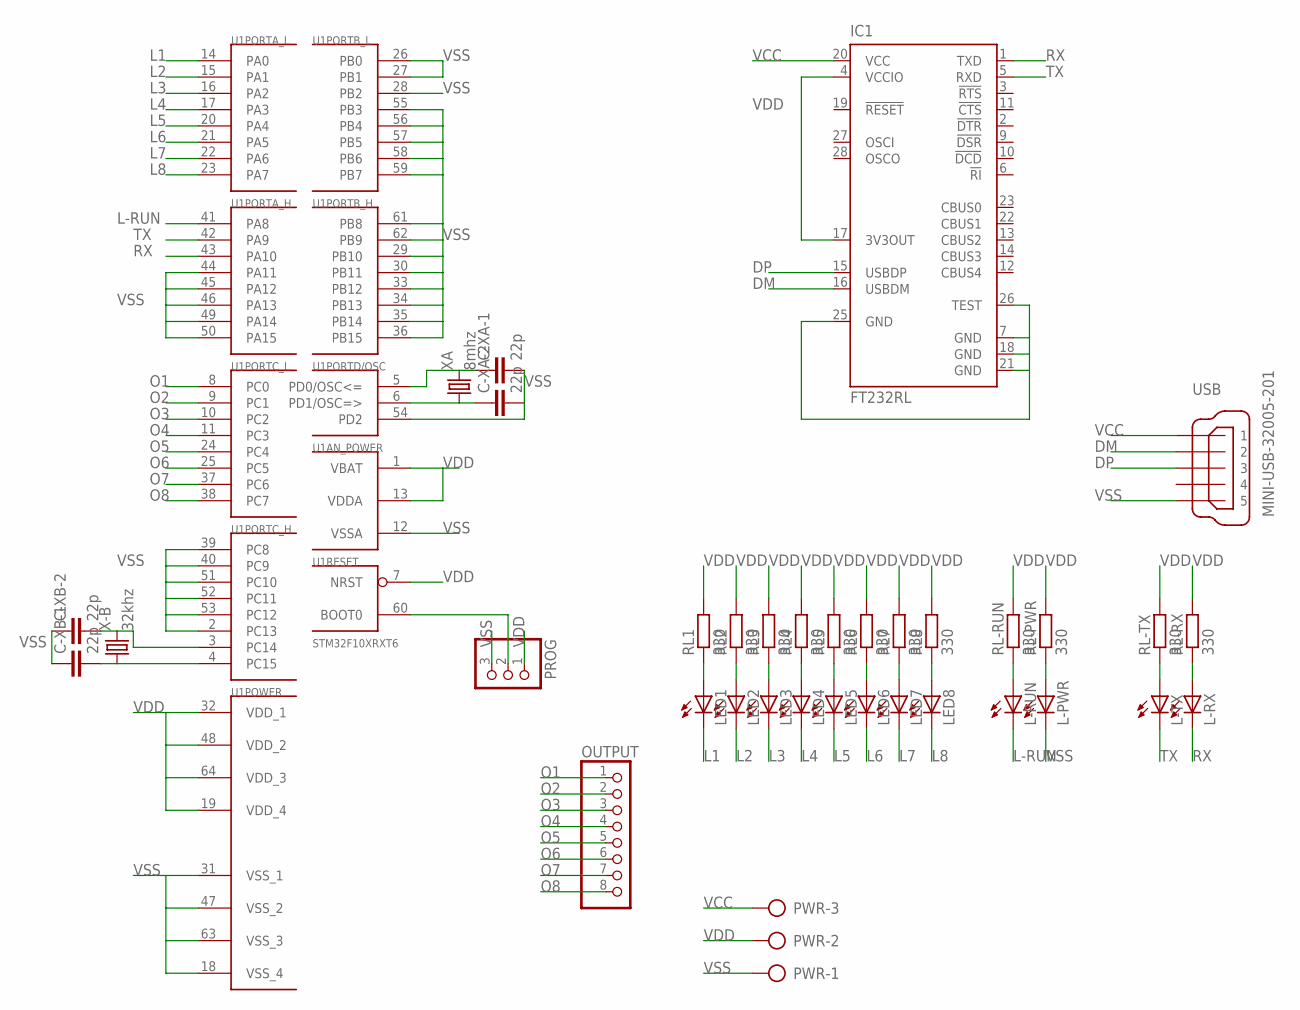
[picture p59: schematic driver_controller.sch]

Parts:
C-XA-1, C-XA-2: 22p; C1206
C-XB-1, C-XB-2: 22p; C1206
IC1: FT232RL; SSOP28
L-PWR: LEDSML1206; SML1206
L-RUN: LEDSML1206; SML1206
L-RX: LEDSML1206; SML1206
L-TX: LEDSML1206; SML1206
LED1, LED2, LED3, LED4, LED5, LED6, LED7, LED8: LEDSML1206; SML1206
OUTPUT: PINHD-1X8; 1X08
PROG: PINHD-1X3; 1X03
PWR: AK300/3
RL1, RL2, RL3, RL4, RL5, RL6, RL7, RL8: 330; R1206
RL-PWR: 330; R1206
RL-RUN: 330; R1206
RL-RX: 330; R1206
RL-TX: 330; R1206
U1: STM32F10XRXT6; TQFP64
USB: MINI-USB-32005-201; 32005-201
X-B: 32khz; TC26V
XA: 8mhz; HC49/S

Connections:
DM: IC1.16 (USBDM), USB.2
DP: IC1.15 (USBDP), USB.3
L1: LED1.C, U1.14 (PA0)
L2: LED2.C, U1.15 (PA1)
L3: LED3.C, U1.16 (PA2)
L4: LED4.C, U1.17 (PA3)
L5: LED5.C, U1.20 (PA4)
L6: LED6.C, U1.21 (PA5)
L7: LED7.C, U1.22 (PA6)
L8: LED8.C, U1.23 (PA7)
L-RUN: L-RUN.C, U1.41 (PA8)
unnamed: PROG.2, U1.60 (BOOT0)
unnamed: C-XB-1.2, U1.4 (PC15), X-B.1
unnamed: C-XB-2.2, U1.3 (PC14), X-B.2
unnamed: LED1.A, RL1.1
unnamed: C-XA-2.1, U1.6 (PD1/OSC=>), XA.1
unnamed: C-XA-1.1, U1.5 (PD0/OSC<=), XA.2
unnamed: LED2.A, RL2.1
unnamed: L-PWR.A, RL-PWR.1
unnamed: LED3.A, RL3.1
unnamed: LED4.A, RL4.1
unnamed: LED5.A, RL5.1
unnamed: LED6.A, RL6.1
unnamed: LED7.A, RL7.1
unnamed: LED8.A, RL8.1
unnamed: L-RUN.A, RL-RUN.1
unnamed: L-TX.A, RL-TX.1
unnamed: L-RX.A, RL-RX.1
O1: OUTPUT.1, U1.8 (PC0)
O2: OUTPUT.2, U1.9 (PC1)
O3: OUTPUT.3, U1.10 (PC2)
O4: OUTPUT.4, U1.11 (PC3)
O5: OUTPUT.5, U1.24 (PC4)
O6: OUTPUT.6, U1.25 (PC5)
O7: OUTPUT.7, U1.37 (PC6)
O8: OUTPUT.8, U1.38 (PC7)
RX: IC1.1 (TXD), L-RX.C, U1.43 (PA10)
TX: IC1.5 (RXD), L-TX.C, U1.42 (PA9)
VCC: IC1.20 (VCC), PWR.3, USB.1
VDD: IC1.4 (VCCIO), IC1.17 (3V3OUT), PROG.1, PWR.2, RL1.2, RL2.2, RL3.2, RL4.2, RL5.2, RL6.2, RL7.2, RL8.2, RL-PWR.2, RL-RUN.2, RL-RX.2, RL-TX.2, U1.1 (VBAT), U1.7 (NRST), U1.13 (VDDA), U1.19 (VDD_4), U1.32 (VDD_1), U1.48 (VDD_2), U1.64 (VDD_3)
VSS: C-XA-1.2, C-XA-2.2, C-XB-1.1, C-XB-2.1, IC1.7 (GND), IC1.18 (GND), IC1.21 (GND), IC1.25 (GND), IC1.26 (TEST), L-PWR.C, PROG.3, PWR.1, U1.2 (PC13), U1.12 (VSSA), U1.18 (VSS_4), U1.26 (PB0), U1.27 (PB1), U1.28 (PB2), U1.29 (PB10), U1.30 (PB11), U1.31 (VSS_1), U1.33 (PB12), U1.34 (PB13), U1.35 (PB14), U1.36 (PB15), U1.39 (PC8), U1.40 (PC9), U1.44 (PA11), U1.45 (PA12), U1.46 (PA13), U1.47 (VSS_2), U1.49 (PA14), U1.50 (PA15), U1.51 (PC10), U1.52 (PC11), U1.53 (PC12), U1.54 (PD2), U1.55 (PB3), U1.56 (PB4), U1.57 (PB5), U1.58 (PB6), U1.59 (PB7), U1.61 (PB8), U1.62 (PB9), U1.63 (VSS_3), USB.5

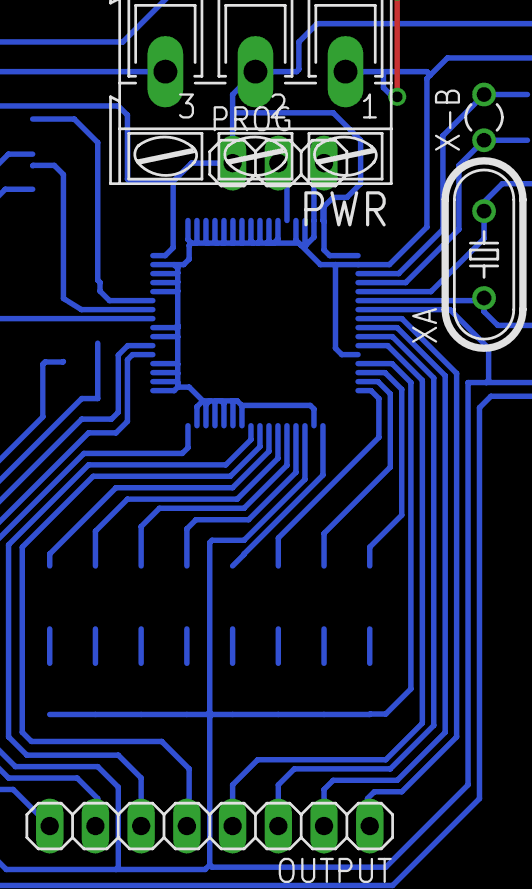
[picture p60: board driver_controller.brd from above]

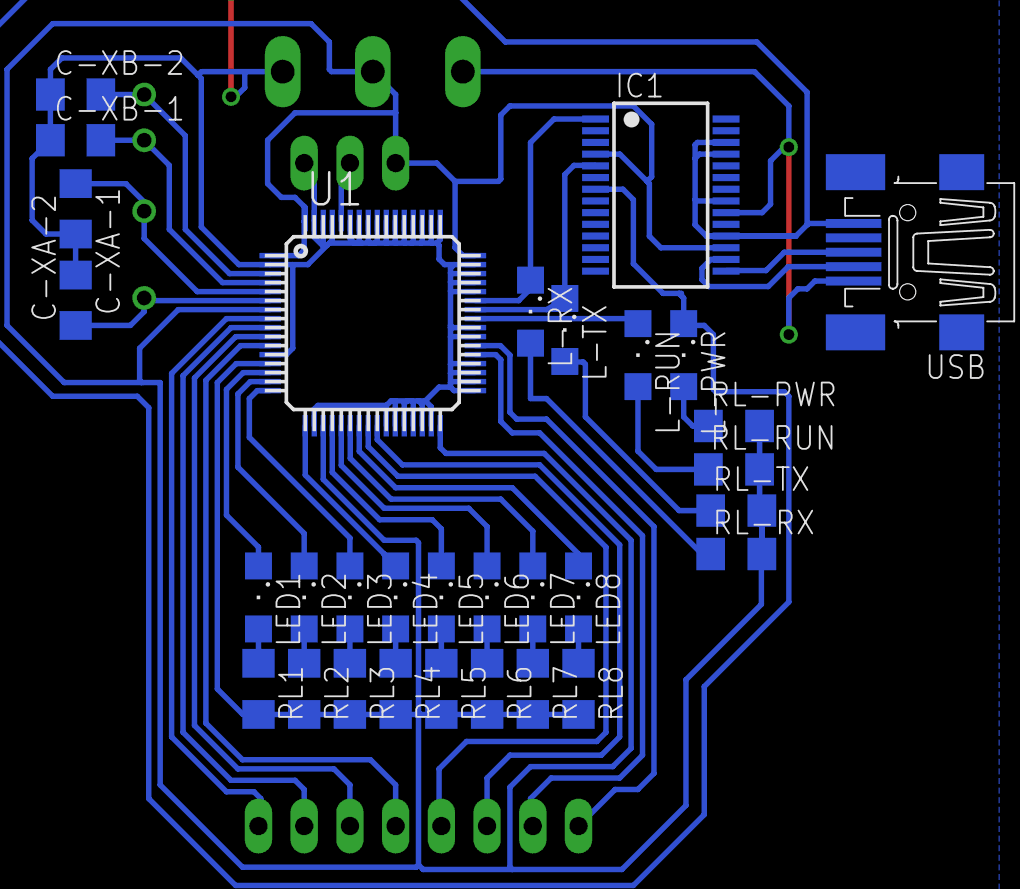
[picture p61: board driver_controller.brd from below]

Board: 2 copper layers, 36 parts (31 on the bottom side), 41 nets.
