mekatronik-achmadi/tugas_akhir/rtos/os/hal/platforms/STM32/TIMv1/icu_lld.h

/*
    ChibiOS/RT - Copyright (C) 2006-2013 Giovanni Di Sirio

    Licensed under the Apache License, Version 2.0 (the "License");
    you may not use this file except in compliance with the License.
    You may obtain a copy of the License at

        http://www.apache.org/licenses/LICENSE-2.0

    Unless required by applicable law or agreed to in writing, software
    distributed under the License is distributed on an "AS IS" BASIS,
    WITHOUT WARRANTIES OR CONDITIONS OF ANY KIND, either express or implied.
    See the License for the specific language governing permissions and
    limitations under the License.
*/

/**
 * @file    STM32/icu_lld.h
 * @brief   STM32 ICU subsystem low level driver header.
 *
 * @addtogroup ICU
 * @{
 */

#ifndef _ICU_LLD_H_
#define _ICU_LLD_H_

#include "stm32_tim.h"

#if HAL_USE_ICU || defined(__DOXYGEN__)

/*===========================================================================*/
/* Driver constants.                                                         */
/*===========================================================================*/

/*===========================================================================*/
/* Driver pre-compile time settings.                                         */
/*===========================================================================*/

/**
 * @name    Configuration options
 * @{
 */
/**
 * @brief   ICUD1 driver enable switch.
 * @details If set to @p TRUE the support for ICUD1 is included.
 * @note    The default is @p TRUE.
 */
#if !defined(STM32_ICU_USE_TIM1) || defined(__DOXYGEN__)
#define STM32_ICU_USE_TIM1                  FALSE
#endif

/**
 * @brief   ICUD2 driver enable switch.
 * @details If set to @p TRUE the support for ICUD2 is included.
 * @note    The default is @p TRUE.
 */
#if !defined(STM32_ICU_USE_TIM2) || defined(__DOXYGEN__)
#define STM32_ICU_USE_TIM2                  FALSE
#endif

/**
 * @brief   ICUD3 driver enable switch.
 * @details If set to @p TRUE the support for ICUD3 is included.
 * @note    The default is @p TRUE.
 */
#if !defined(STM32_ICU_USE_TIM3) || defined(__DOXYGEN__)
#define STM32_ICU_USE_TIM3                  FALSE
#endif

/**
 * @brief   ICUD4 driver enable switch.
 * @details If set to @p TRUE the support for ICUD4 is included.
 * @note    The default is @p TRUE.
 */
#if !defined(STM32_ICU_USE_TIM4) || defined(__DOXYGEN__)
#define STM32_ICU_USE_TIM4                  FALSE
#endif

/**
 * @brief   ICUD5 driver enable switch.
 * @details If set to @p TRUE the support for ICUD5 is included.
 * @note    The default is @p TRUE.
 */
#if !defined(STM32_ICU_USE_TIM5) || defined(__DOXYGEN__)
#define STM32_ICU_USE_TIM5                  FALSE
#endif

/**
 * @brief   ICUD8 driver enable switch.
 * @details If set to @p TRUE the support for ICUD8 is included.
 * @note    The default is @p TRUE.
 */
#if !defined(STM32_ICU_USE_TIM8) || defined(__DOXYGEN__)
#define STM32_ICU_USE_TIM8                  FALSE
#endif

/**
 * @brief   ICUD9 driver enable switch.
 * @details If set to @p TRUE the support for ICUD9 is included.
 * @note    The default is @p TRUE.
 */
#if !defined(STM32_ICU_USE_TIM9) || defined(__DOXYGEN__)
#define STM32_ICU_USE_TIM9                  FALSE
#endif

/**
 * @brief   ICUD1 interrupt priority level setting.
 */
#if !defined(STM32_ICU_TIM1_IRQ_PRIORITY) || defined(__DOXYGEN__)
#define STM32_ICU_TIM1_IRQ_PRIORITY         7
#endif

/**
 * @brief   ICUD2 interrupt priority level setting.
 */
#if !defined(STM32_ICU_TIM2_IRQ_PRIORITY) || defined(__DOXYGEN__)
#define STM32_ICU_TIM2_IRQ_PRIORITY         7
#endif

/**
 * @brief   ICUD3 interrupt priority level setting.
 */
#if !defined(STM32_ICU_TIM3_IRQ_PRIORITY) || defined(__DOXYGEN__)
#define STM32_ICU_TIM3_IRQ_PRIORITY         7
#endif

/**
 * @brief   ICUD4 interrupt priority level setting.
 */
#if !defined(STM32_ICU_TIM4_IRQ_PRIORITY) || defined(__DOXYGEN__)
#define STM32_ICU_TIM4_IRQ_PRIORITY         7
#endif

/**
 * @brief   ICUD5 interrupt priority level setting.
 */
#if !defined(STM32_ICU_TIM5_IRQ_PRIORITY) || defined(__DOXYGEN__)
#define STM32_ICU_TIM5_IRQ_PRIORITY         7
#endif

/**
 * @brief   ICUD8 interrupt priority level setting.
 */
#if !defined(STM32_ICU_TIM8_IRQ_PRIORITY) || defined(__DOXYGEN__)
#define STM32_ICU_TIM8_IRQ_PRIORITY         7
#endif

/**
 * @brief   ICUD9 interrupt priority level setting.
 */
#if !defined(STM32_ICU_TIM9_IRQ_PRIORITY) || defined(__DOXYGEN__)
#define STM32_ICU_TIM9_IRQ_PRIORITY         7
#endif
/** @} */

/*===========================================================================*/
/* Derived constants and error checks.                                       */
/*===========================================================================*/

#if STM32_ICU_USE_TIM1 && !STM32_HAS_TIM1
#error "TIM1 not present in the selected device"
#endif

#if STM32_ICU_USE_TIM2 && !STM32_HAS_TIM2
#error "TIM2 not present in the selected device"
#endif

#if STM32_ICU_USE_TIM3 && !STM32_HAS_TIM3
#error "TIM3 not present in the selected device"
#endif

#if STM32_ICU_USE_TIM4 && !STM32_HAS_TIM4
#error "TIM4 not present in the selected device"
#endif

#if STM32_ICU_USE_TIM5 && !STM32_HAS_TIM5
#error "TIM5 not present in the selected device"
#endif

#if STM32_ICU_USE_TIM8 && !STM32_HAS_TIM8
#error "TIM8 not present in the selected device"
#endif

#if STM32_ICU_USE_TIM9 && !STM32_HAS_TIM9
#error "TIM9 not present in the selected device"
#endif

#if !STM32_ICU_USE_TIM1 && !STM32_ICU_USE_TIM2 &&                           \
    !STM32_ICU_USE_TIM3 && !STM32_ICU_USE_TIM4 &&                           \
    !STM32_ICU_USE_TIM5 && !STM32_ICU_USE_TIM8 &&                           \
    !STM32_ICU_USE_TIM9
#error "ICU driver activated but no TIM peripheral assigned"
#endif

#if STM32_ICU_USE_TIM1 &&                                                   \
    !CORTEX_IS_VALID_KERNEL_PRIORITY(STM32_ICU_TIM1_IRQ_PRIORITY)
#error "Invalid IRQ priority assigned to TIM1"
#endif

#if STM32_ICU_USE_TIM2 &&                                                   \
    !CORTEX_IS_VALID_KERNEL_PRIORITY(STM32_ICU_TIM2_IRQ_PRIORITY)
#error "Invalid IRQ priority assigned to TIM2"
#endif

#if STM32_ICU_USE_TIM3 &&                                                   \
    !CORTEX_IS_VALID_KERNEL_PRIORITY(STM32_ICU_TIM3_IRQ_PRIORITY)
#error "Invalid IRQ priority assigned to TIM3"
#endif

#if STM32_ICU_USE_TIM4 &&                                                   \
    !CORTEX_IS_VALID_KERNEL_PRIORITY(STM32_ICU_TIM4_IRQ_PRIORITY)
#error "Invalid IRQ priority assigned to TIM4"
#endif

#if STM32_ICU_USE_TIM5 &&                                                   \
    !CORTEX_IS_VALID_KERNEL_PRIORITY(STM32_ICU_TIM5_IRQ_PRIORITY)
#error "Invalid IRQ priority assigned to TIM5"
#endif
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
