mekatronik-achmadi/tugas_akhir/(commit log)

2014-09-27 Proposal sudah print (lanjutkan)
    board driver contoller and fet
    [driver_controller.brd, driver_controller.sch, driver_fet.brd, driver_fet.sch]
2014-09-28 ganti pake mini USB
    [driver_controller.brd, driver_controller.sch]
2014-10-01 Proposal tinggal tinjauan teori
    [driver_controller.brd, driver_fet.brd]
2014-10-02 flowchart color tracking
2014-10-20 until RTOS running
    [components_all.csv, driver_controller.csv, driver_fet.csv]
2014-12-05 data jarak
    [Data_Jarak.ods]
2015-01-02 progress 2
    [Data_Jarak_to_book.ods, driver_controller.brd, driver_fet.brd]
2015-01-04 print buat pendaftaran
2015-01-08 Daftar seminar
    [Data_Jarak_to_book.xls]
